annaivanytska/virtualLaboratory/app.png

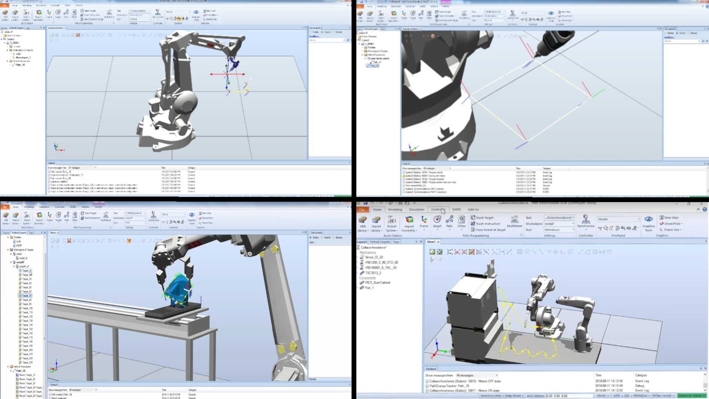
app.png
