annaivanytska/virtualLaboratory/src/model/kkk.png

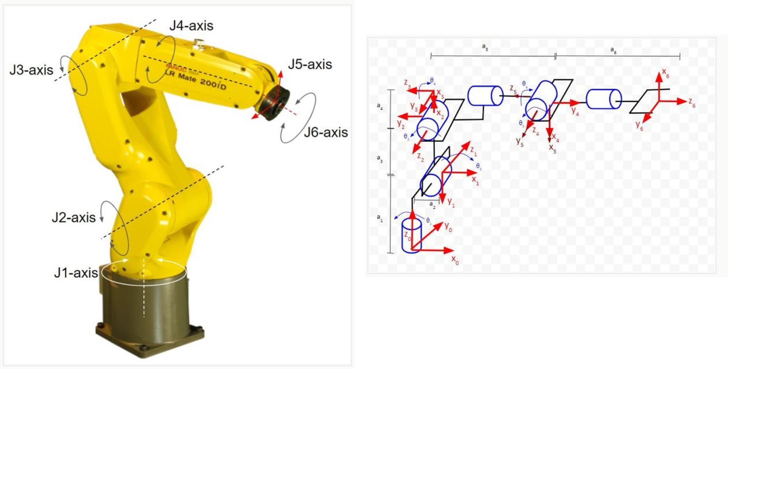
src/model/kkk.png
