annaivanytska/virtualLaboratory/models/Kawasaki/Rysunki 3D/Robot FS006L/człon_3.stl

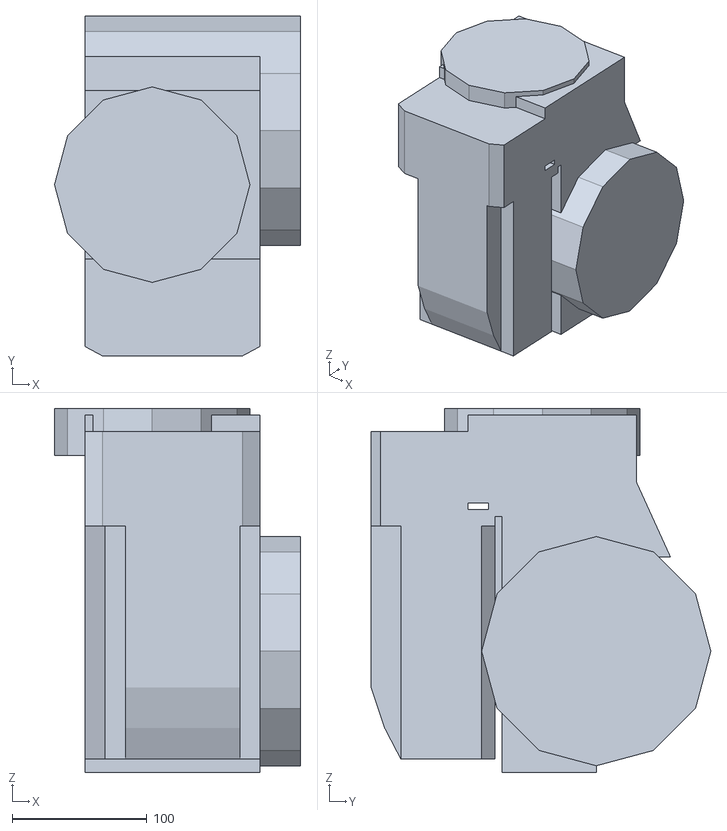
[picture p4: CAD file, 2024-10-11]
models/Kawasaki/Rysunki 3D/Robot FS006L/człon_3.stl
182.5 x 252.0 x 270.0
