annaivanytska/virtualLaboratory/models/Kawasaki/Rysunki 3D/Robot FS060L/fs006l-ip.dxf

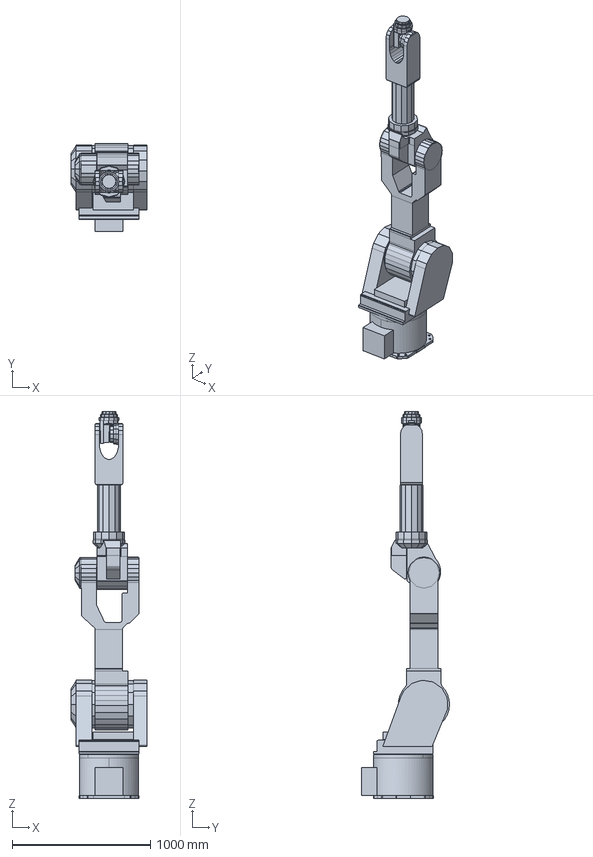
[picture p5: CAD file, 2024-10-11]
models/Kawasaki/Rysunki 3D/Robot FS060L/fs006l-ip.dxf
547.0 x 636.2 x 2796.0 mm
