annaivanytska/virtualLaboratory/models/Kawasaki/Rysunki 3D/Robot RS003N/RS003N.stp

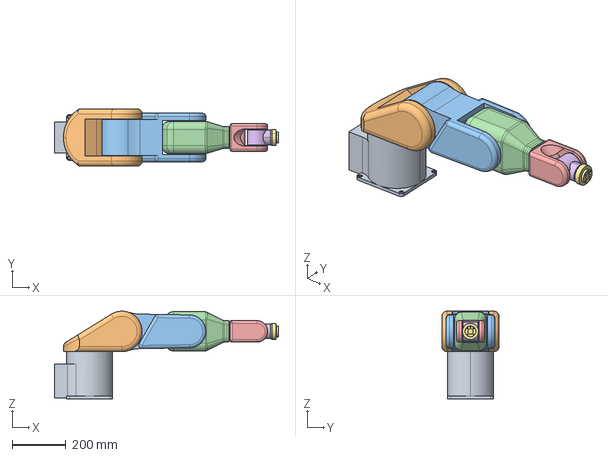
[picture p6: CAD file, 2024-10-11]
models/Kawasaki/Rysunki 3D/Robot RS003N/RS003N.stp
830.0 x 212.0 x 324.9 mm
