annaivanytska/virtualLaboratory/models/Mitsubishi/Rysunki 3D/RV-12/_RV_12SL__RV_12SDL 0/podstawa.stl

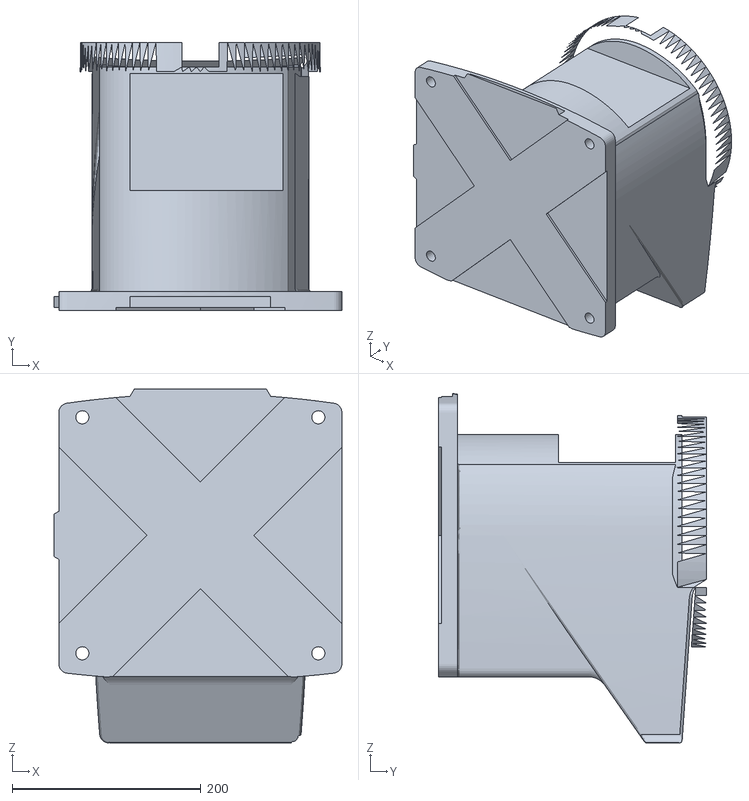
[picture p7: CAD file, 2024-10-11]
models/Mitsubishi/Rysunki 3D/RV-12/_RV_12SL__RV_12SDL 0/podstawa.stl
305.0 x 284.0 x 375.0
