annaivanytska/virtualLaboratory/models/Mitsubishi/Rysunki 3D/RV-12/RV_12SL_Robot_arm_dimensions.dxf

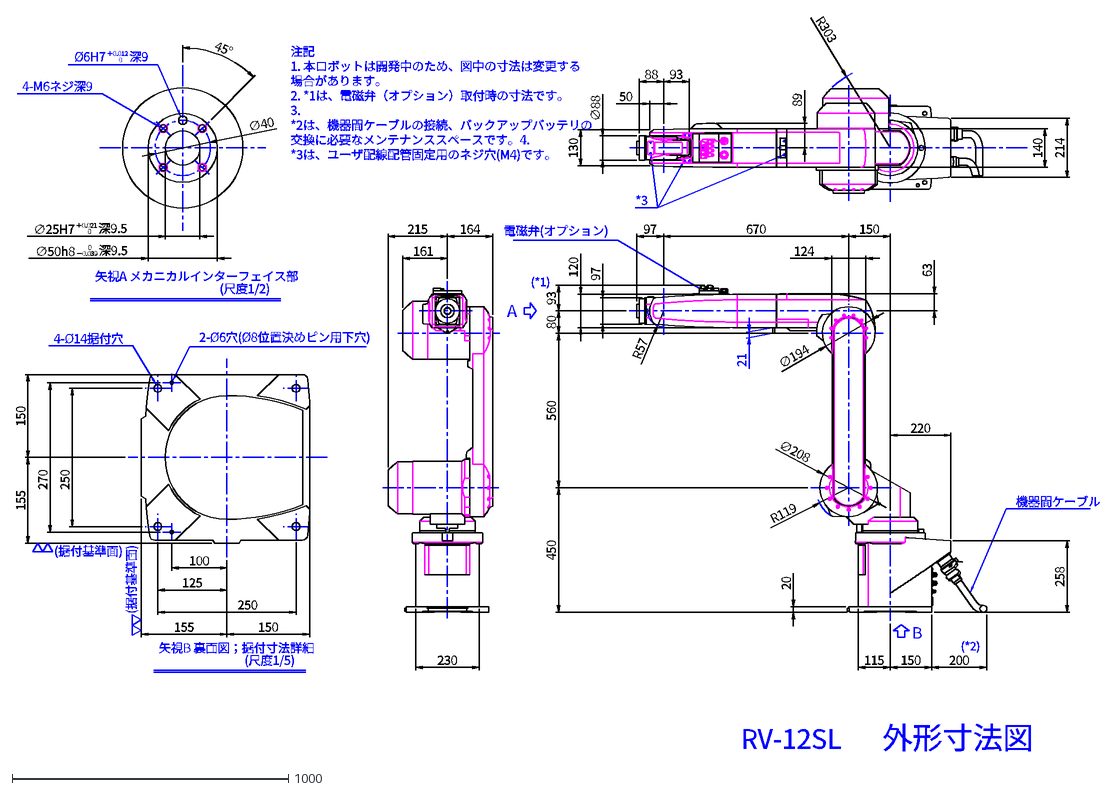
[picture p8: CAD file, 2024-10-11]
models/Mitsubishi/Rysunki 3D/RV-12/RV_12SL_Robot_arm_dimensions.dxf
2-Ø6穴(Ø8位置決めピン用下穴)
155
250
270
150
矢視B 裏面図；据付寸法詳細
125
100
(尺度1/5)
45°
∅25H7 ＋0.021^ 0 深9.5
∅50h8 0^ －0.039 深9.5
4-Ø14据付穴
矢視A メカニカルインターフェイス部
(尺度1/2)
∅40
Ø6H7 ＋0.012^ 0 深9
560
∅208
220
450
R119
230
機器間ケーブル
258
外形寸法図
RV-12SL
115
B
200
(*2)
124
R303
670
∅194
63
電磁弁(オプション)
(*1)
130
93
80
215
164
161
A
97
120
R57
88
50
∅88
89
注記 1. 本ロボットは開発中のため、図中の寸法は変更する 場合があります。 2. *1は、電磁弁（オプション）取付時の寸法です。 3. *2は、機器間ケーブルの接続、バックアップバッテリの 交換に必要なメンテナンススペースです。 4. *3は、ユーザ配線配管固定用のネジ穴(M4)です。
140
214
(据付基準面)
20
*3
4-M6ネジ深9
21
