annaivanytska/virtualLaboratory/models/Modele 3D/Kawasaki/fs006l.stp

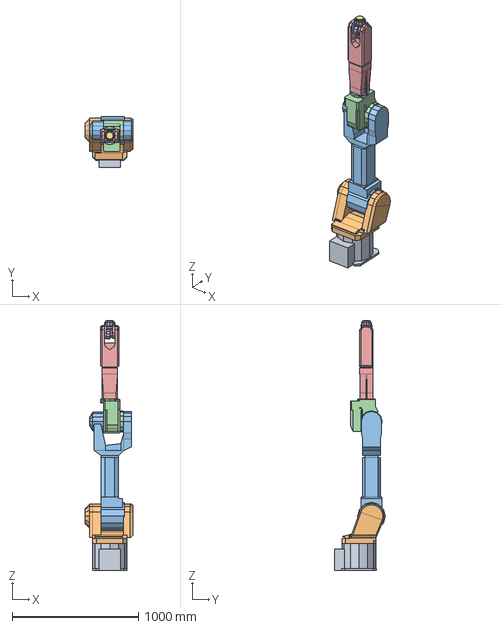
[picture p9: CAD file, 2024-10-11]
models/Modele 3D/Kawasaki/fs006l.stp
378.0 x 402.0 x 1980.0 mm
