annaivanytska/virtualLaboratory/models/Modele 3D/Mitsubishi/RV-12/_RV_12SL__RV_12SDL 0/rv-12sl_top.stp

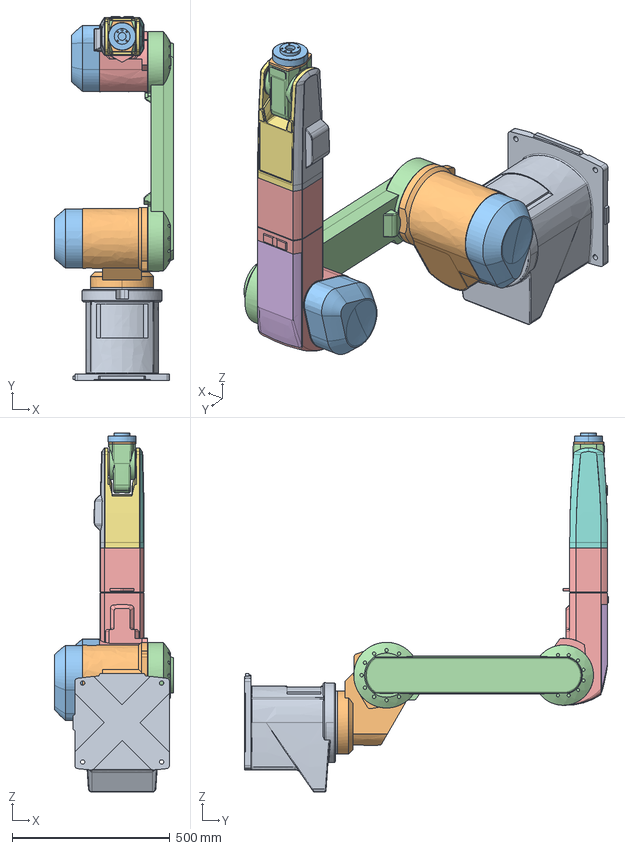
[picture p10: CAD file, 2024-10-11]
models/Modele 3D/Mitsubishi/RV-12/_RV_12SL__RV_12SDL 0/rv-12sl_top.stp
378.5 x 1153.0 x 1137.0 mm
RV-12SL_SKELTON
RV-12S_BASE
RV-12S_SHOULDER
RV-12S_SHOULDER_COVER x 2
RV-12SL_NO1ARM
RV-12S_ELBO
RV-12S_ELBO_COVER_A
RV-12S_NO2ARM
RV-12S_NO2ARM_COVER_A
RV-12S_NO2ARM_COVER_B
RV-12S_J6_CRBRG_SPACER
RV-12S_J6_FLANGE
RV-12S_WRIST
RV-12SL_J4_EX_FLANGE
