annaivanytska/virtualLaboratory/models/Modele 3D/Mitsubishi/RV-12/_RV_12SL__RV_12SDL 1/rv-12sl_no1arm.igs

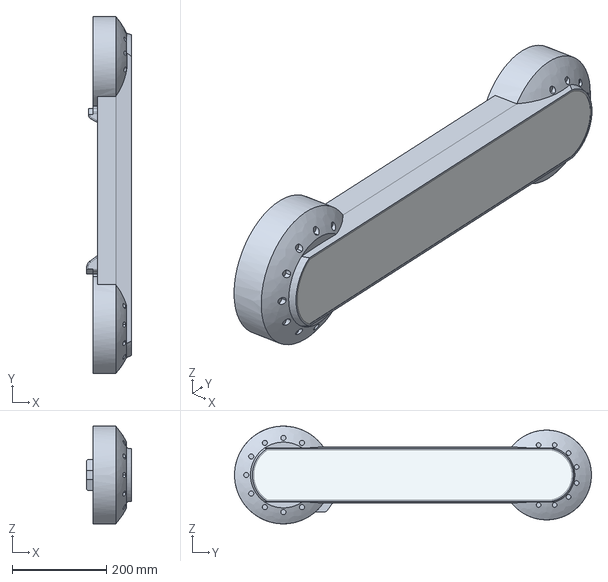
[picture p11: CAD file, 2024-10-11]
models/Modele 3D/Mitsubishi/RV-12/_RV_12SL__RV_12SDL 1/rv-12sl_no1arm.igs
95.0 x 759.5 x 207.9 mm
