annaivanytska/virtualLaboratory/models/Modele 3D/Modele STL/mitsubishi/rv-12s_j6_crbrg_spacer.stl

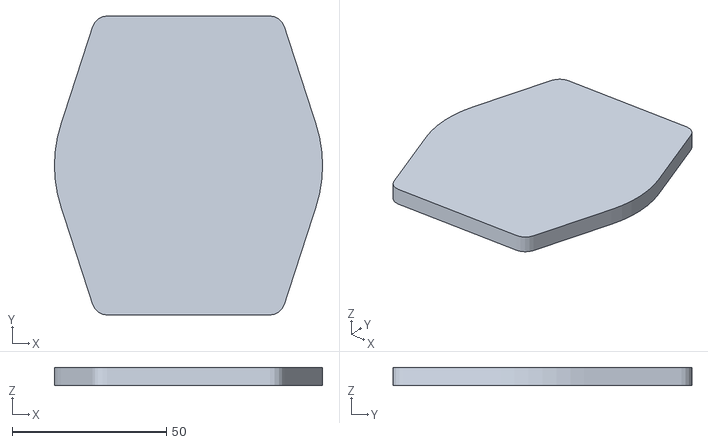
[picture p12: CAD file, 2024-10-11]
models/Modele 3D/Modele STL/mitsubishi/rv-12s_j6_crbrg_spacer.stl
87.0 x 97.0 x 6.00
