annaivanytska/virtualLaboratory/src/kawasaki/23.stl

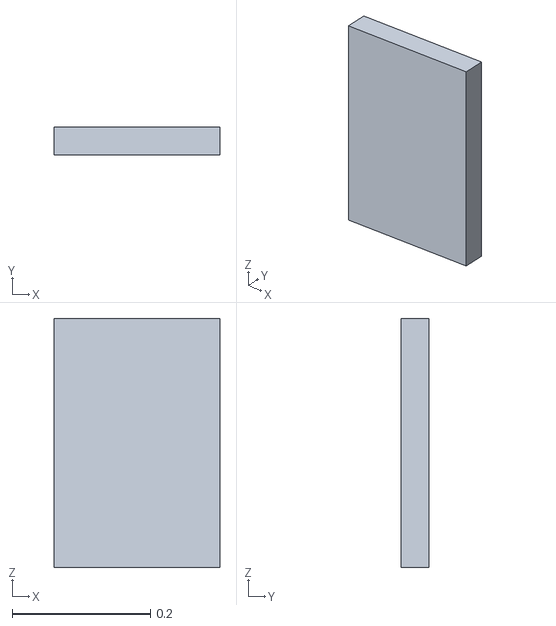
[picture p13: CAD file, 2025-04-29]
src/kawasaki/23.stl
0.24 x 0.04 x 0.36
