annaivanytska/virtualLaboratory/models/Kawasaki/Rysunki 3D/Robot FS006L/człon_2.stl

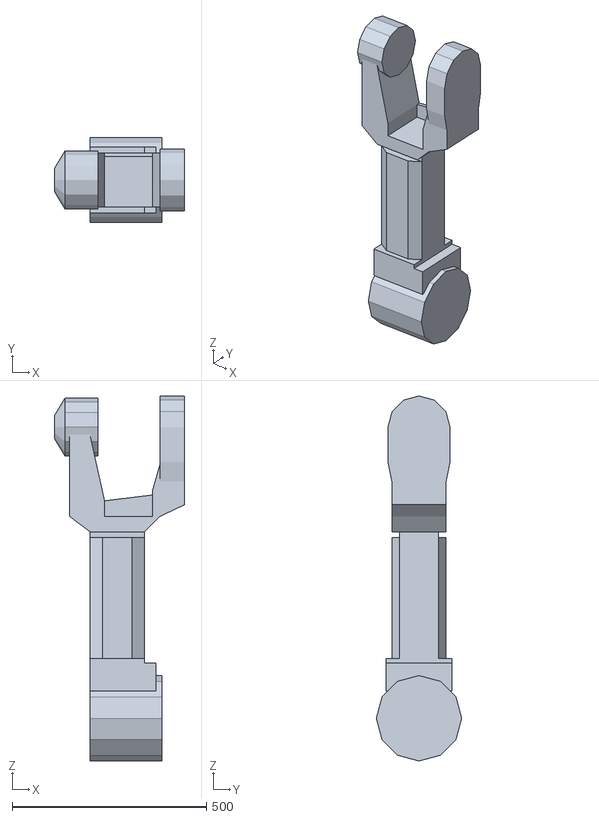
[picture p15: CAD file, 2024-10-11]
models/Kawasaki/Rysunki 3D/Robot FS006L/człon_2.stl
335.0 x 220.0 x 940.0
