annaivanytska/virtualLaboratory/models/Mitsubishi/Rysunki 3D/RV-12/RV_12SL_Robot_arm_reach__dimensioned_.dxf

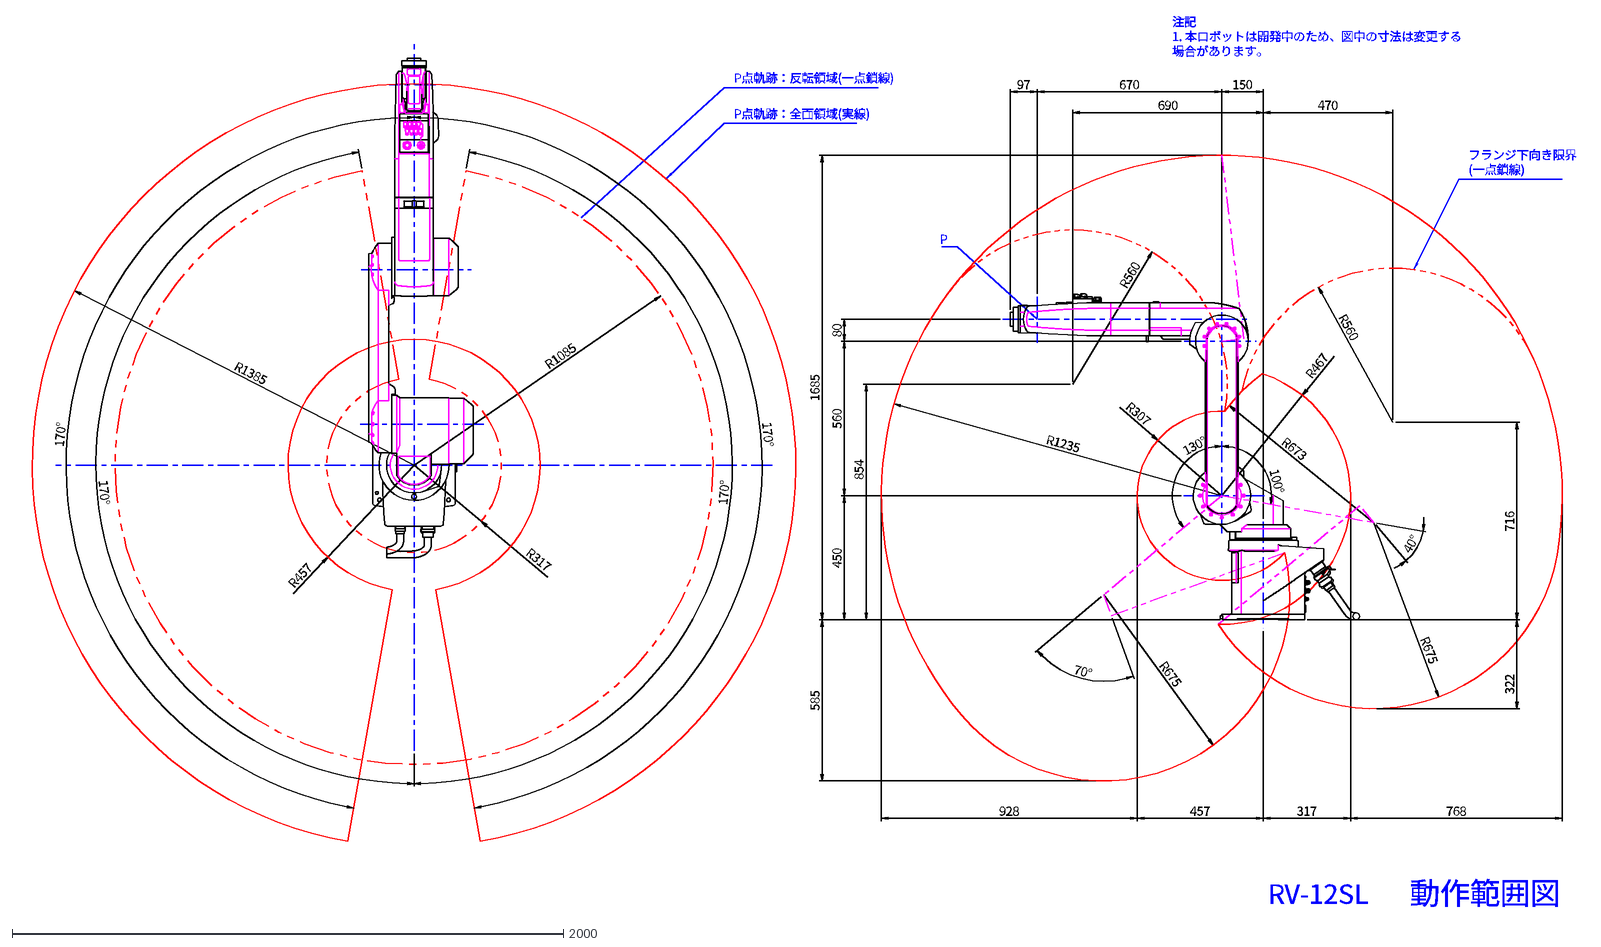
[picture p16: CAD file, 2024-10-11]
models/Mitsubishi/Rysunki 3D/RV-12/RV_12SL_Robot_arm_reach__dimensioned_.dxf
動作範囲図
RV-12SL
560
450
80
150
670
97
457
928
317
768
585
1685
690
854
716
470
R307
R560
R1235
R467
R673
R675
130°
100°
170°
R1385
R1085
R457
R317
P
フランジ下向き限界 (一点鎖線)
P点軌跡：全面領域(実線)
P点軌跡：反転領域(一点鎖線)
注記 1. 本ロボットは開発中のため、図中の寸法は変更する 場合があります。
70°
40°
322
