annaivanytska/virtualLaboratory/models/Modele 3D/Kawasaki/podstawa.stl

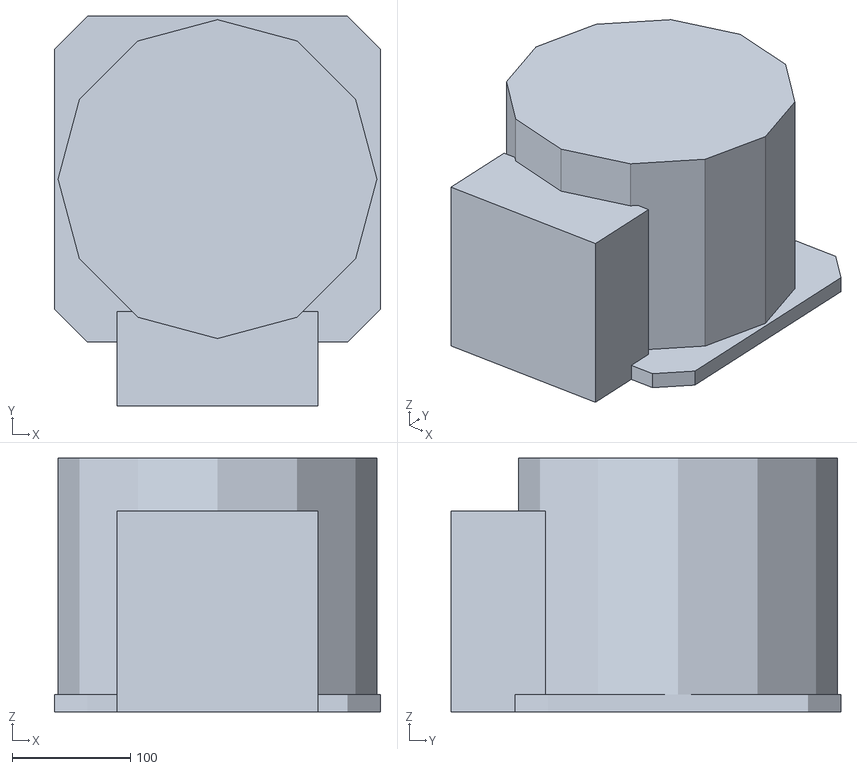
[picture p17: CAD file, 2024-10-11]
models/Modele 3D/Kawasaki/podstawa.stl
276.0 x 330.0 x 215.0
