annaivanytska/virtualLaboratory/models/Modele 3D/Mitsubishi/RV-12/_RV_12SL__RV_12SDL 1/rv-12s_elbo.igs

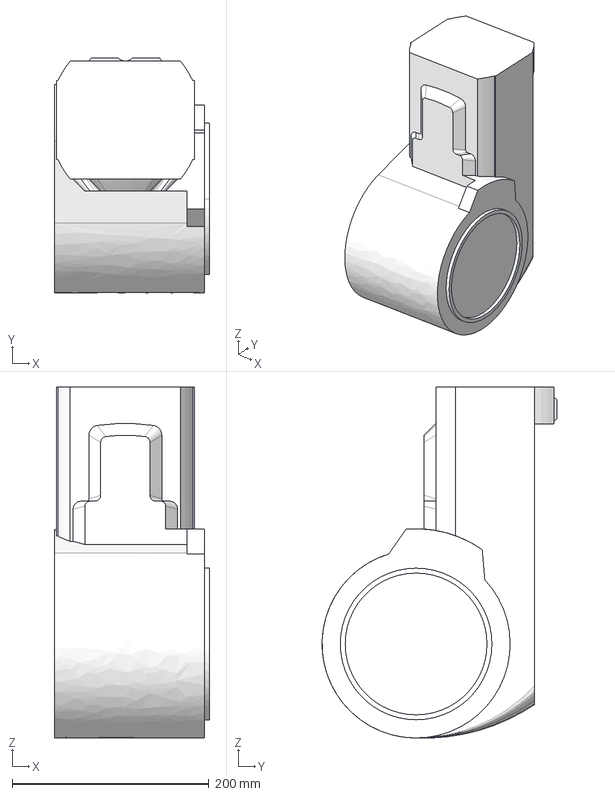
[picture p18: CAD file, 2024-10-11]
models/Modele 3D/Mitsubishi/RV-12/_RV_12SL__RV_12SDL 1/rv-12s_elbo.igs
157.5 x 238.5 x 356.5 mm
