annaivanytska/virtualLaboratory/models/Modele 3D/Modele STL/kawasaki/czlon_1.ply

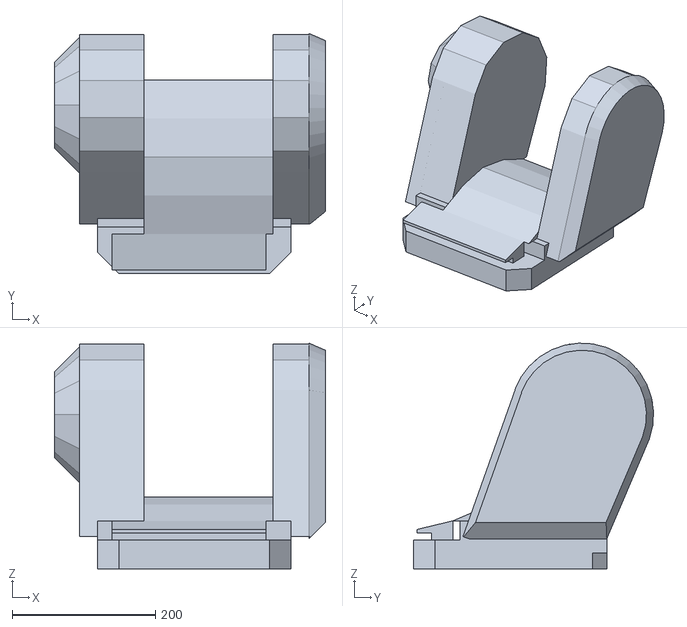
[picture p19: CAD file, 2024-10-11]
models/Modele 3D/Modele STL/kawasaki/czlon_1.ply
378.0 x 334.9 x 314.9
