annaivanytska/virtualLaboratory/src/model/1-5.stl

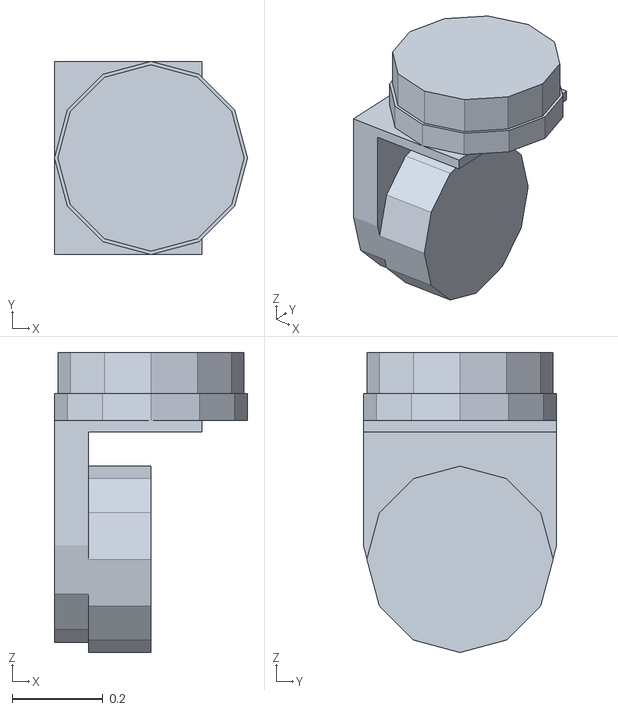
[picture p20: CAD file, 2025-04-29]
src/model/1-5.stl
0.425 x 0.425 x 0.66
