annaivanytska/virtualLaboratory/models/Kawasaki/Rysunki 3D/Robot FS006L/człon_4.stl

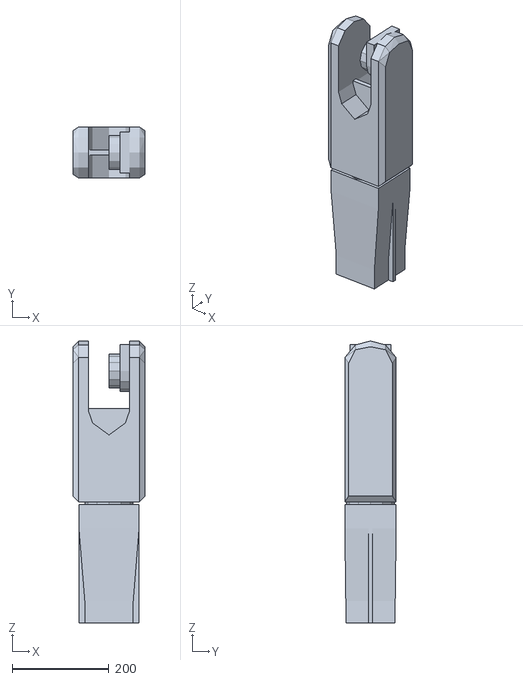
[picture p21: CAD file, 2024-10-11]
models/Kawasaki/Rysunki 3D/Robot FS006L/człon_4.stl
149.0 x 106.0 x 582.0
