annaivanytska/virtualLaboratory/models/Modele 3D/Kawasaki/człon_6_flansza.stl

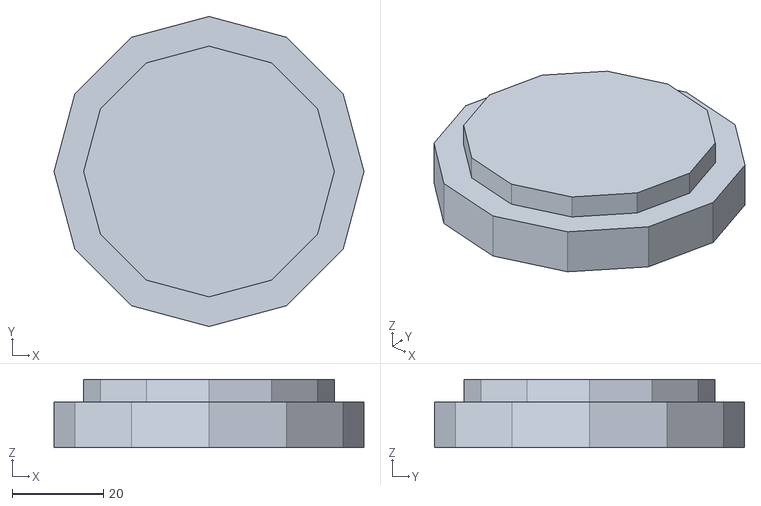
[picture p22: CAD file, 2024-10-11]
models/Modele 3D/Kawasaki/człon_6_flansza.stl
68.0 x 68.0 x 15.0
