annaivanytska/virtualLaboratory/models/Modele 3D/Mitsubishi/RV-12/_RV_12SL__RV_12SDL 1/człon_0_podstawa.stl

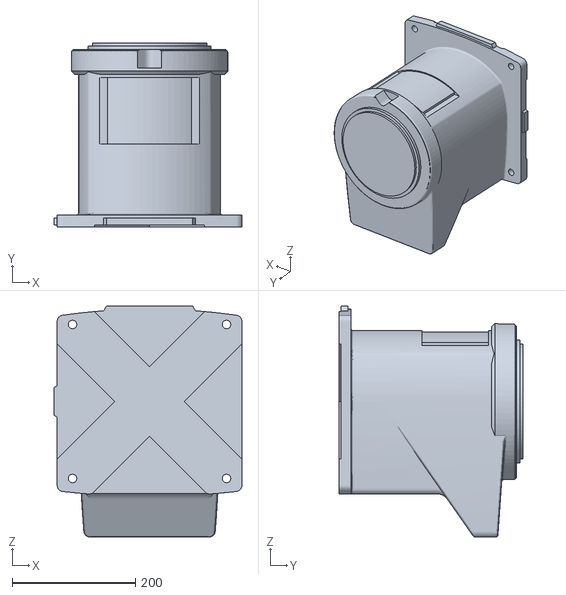
[picture p23: CAD file, 2024-10-11]
models/Modele 3D/Mitsubishi/RV-12/_RV_12SL__RV_12SDL 1/człon_0_podstawa.stl
305.0 x 299.0 x 375.0
