annaivanytska/virtualLaboratory/src/model/000.obj

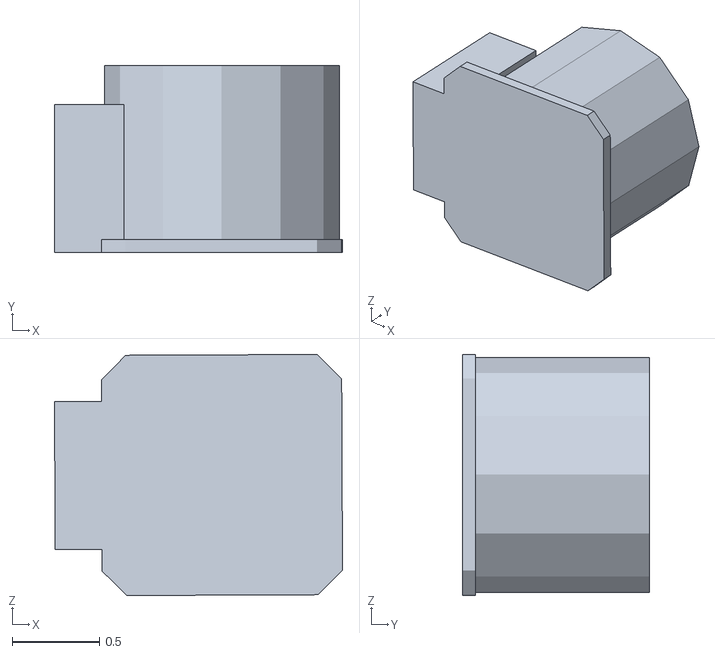
[picture p24: CAD file, 2025-04-29]
src/model/000.obj
1.65 x 1.07 x 1.38
