annaivanytska/virtualLaboratory/models/Kawasaki/Rysunki 3D/Robot FS006L/fs006l-ip.dxf

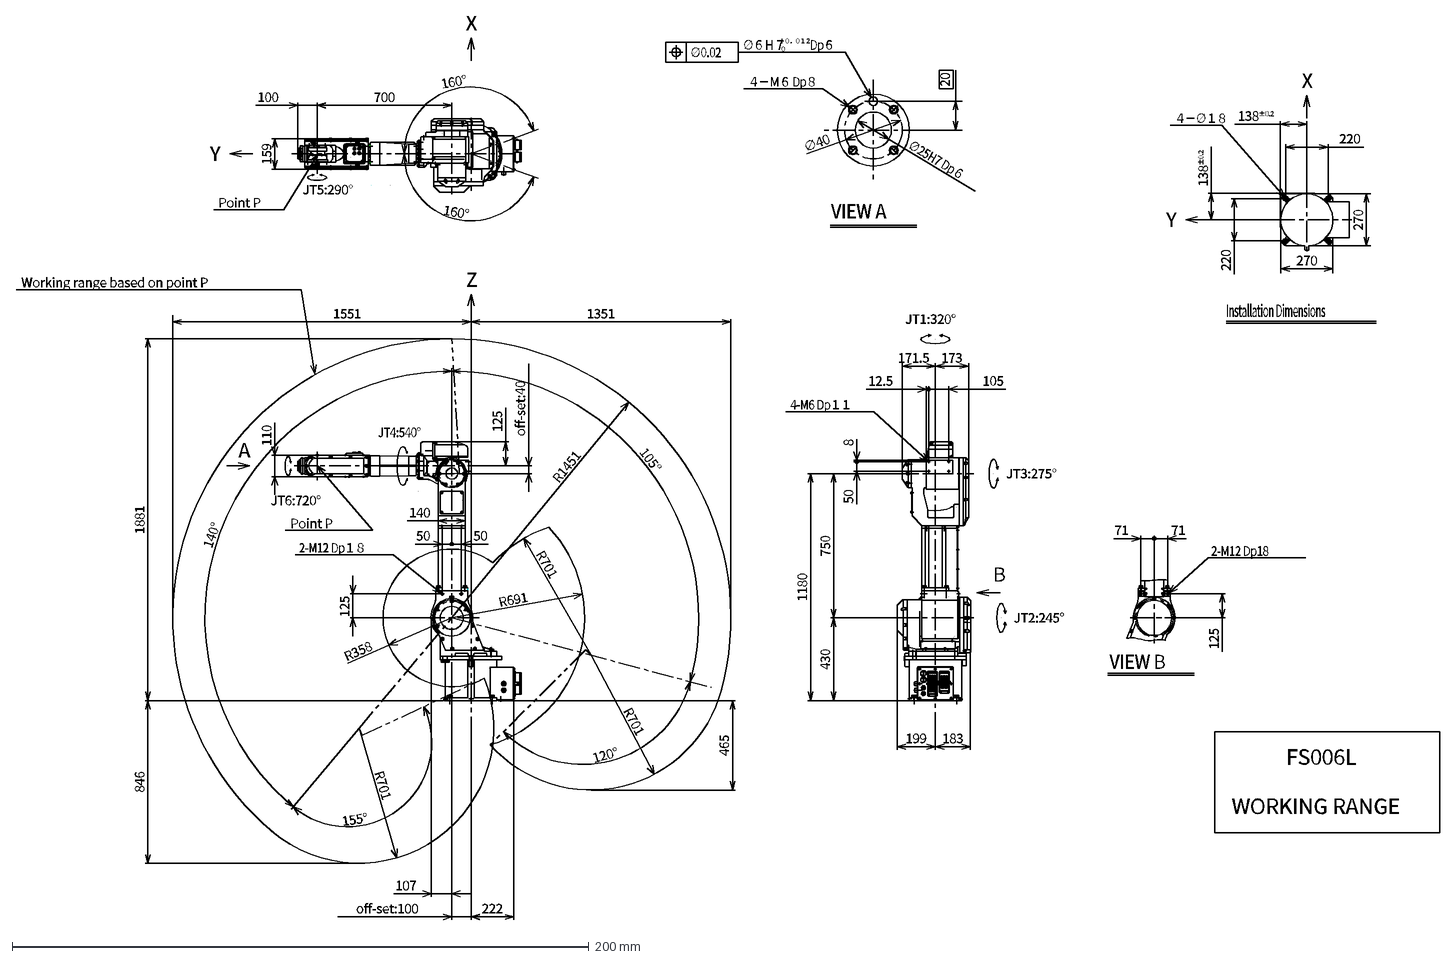
[picture p25: CAD file, 2024-10-11]
models/Kawasaki/Rysunki 3D/Robot FS006L/fs006l-ip.dxf
JT5:290°
Y
X
B
JT1:320°
JT2:245°
JT6:720°
A
Z
VIEW B
JT3:275°
JT4:540°
Installation Dimensions
105°
846
1881
100
160°
222
125
50
2-M12 Dp18
71
8
4-M6 Dp１１
12.5
171.5
173
R701
183
430
140°
140
107
R1451
off-set:40
off-set:100
R691
1351
465
1551
R358
270
220
138±0.2^
４－∅１８
700
750
1180
155°
120°
199
Point P
Working range based on point P
2-M12 Dp１８
105
159
110
WORKING RANGE
FS006L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
