annaivanytska/virtualLaboratory/models/Mitsubishi/Rysunki 3D/RV-12/_RV_12SL__RV_12SDL 1/rv-12s_no2arm.igs

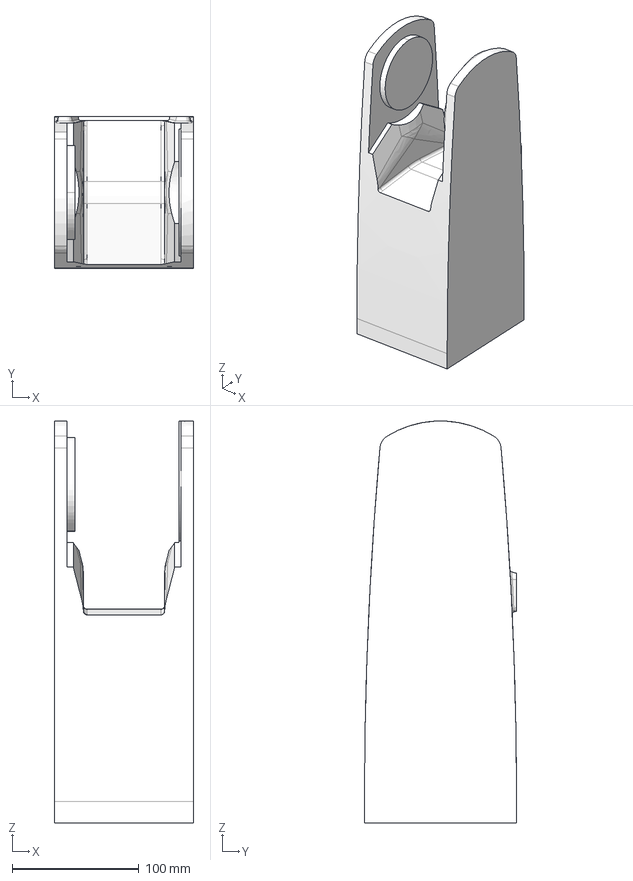
[picture p26: CAD file, 2024-10-11]
models/Mitsubishi/Rysunki 3D/RV-12/_RV_12SL__RV_12SDL 1/rv-12s_no2arm.igs
110.0 x 120.0 x 317.0 mm
