annaivanytska/virtualLaboratory/src/kawasaki/4a.stl

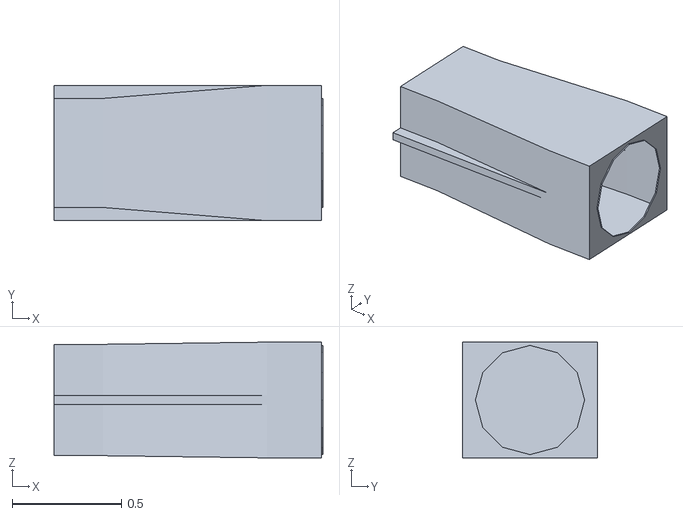
[picture p27: CAD file, 2025-04-29]
src/kawasaki/4a.stl
1.23 x 0.62 x 0.53
