annaivanytska/virtualLaboratory/src/model/1-4a.stl

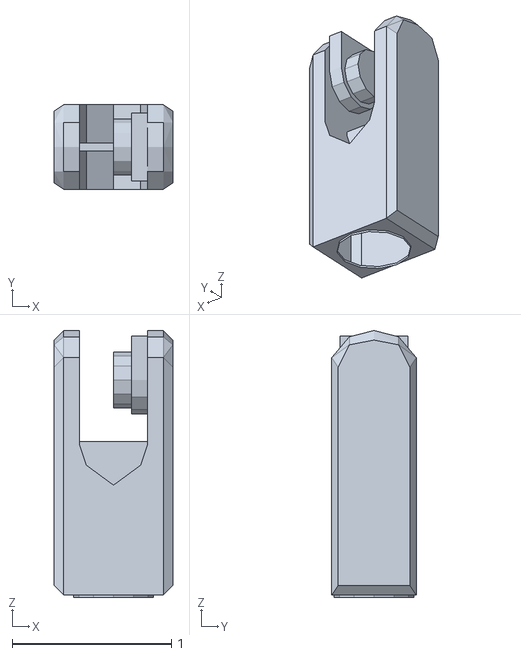
[picture p28: CAD file, 2025-04-29]
src/model/1-4a.stl
0.745 x 0.53 x 1.67
