annaivanytska/virtualLaboratory/models/Modele 3D/Kawasaki/człon_5.stl

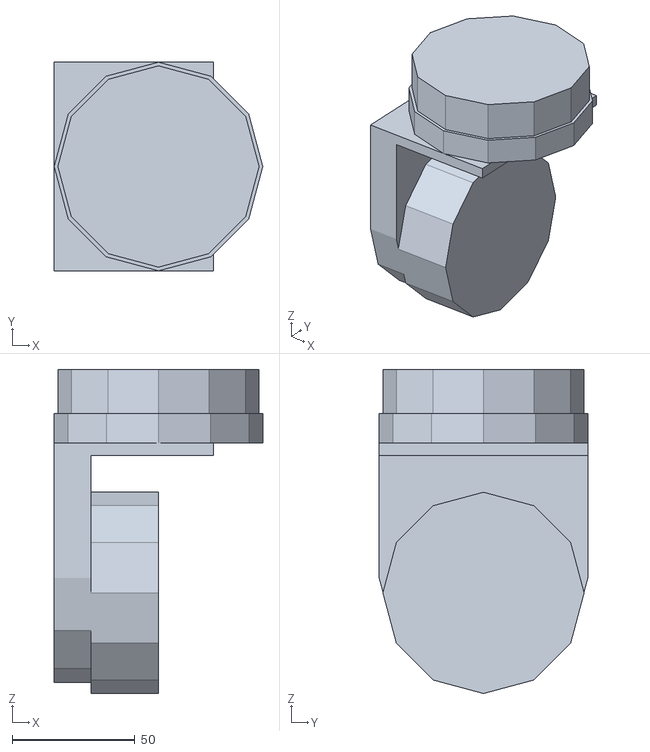
[picture p29: CAD file, 2024-10-11]
models/Modele 3D/Kawasaki/człon_5.stl
85.0 x 85.0 x 132.0
