annaivanytska/virtualLaboratory/models/Modele 3D/Modele STL/mitsubishi/rv-12s_no2arm_cover_a.stl

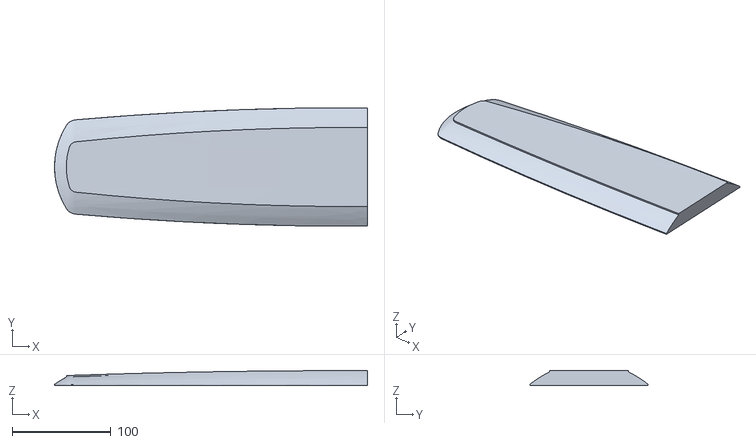
[picture p30: CAD file, 2024-10-11]
models/Modele 3D/Modele STL/mitsubishi/rv-12s_no2arm_cover_a.stl
317.0 x 120.0 x 15.0
