annaivanytska/virtualLaboratory/src/kawasaki/1.stl

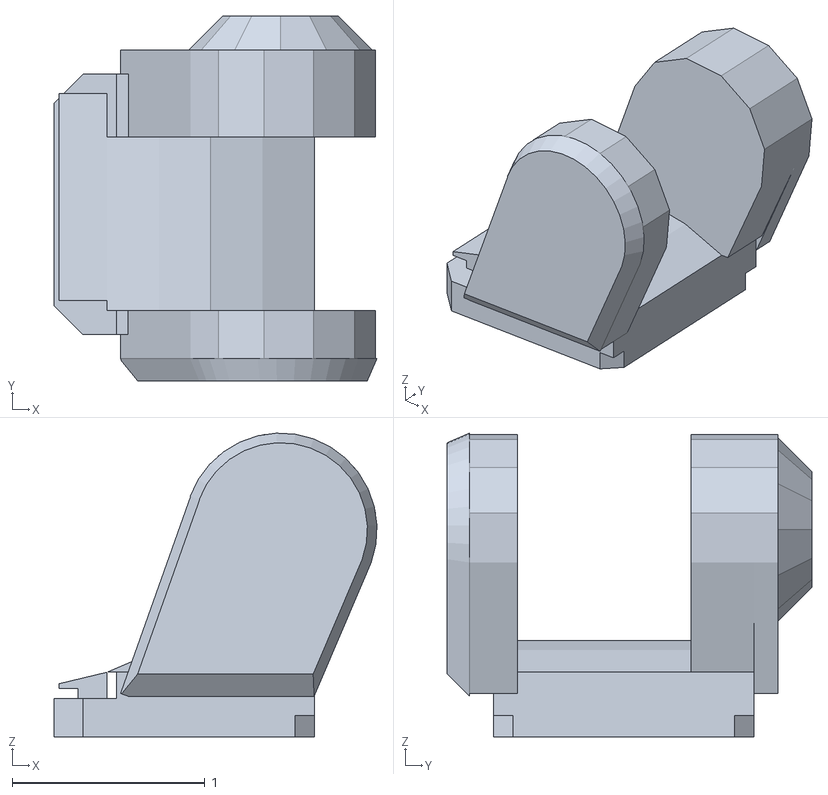
[picture p31: CAD file, 2025-04-29]
src/kawasaki/1.stl
1.67 x 1.89 x 1.57
