annaivanytska/virtualLaboratory/models/Modele 3D/Modele STL/mitsubishi/rv-12sl_j4_ex_flange.stl

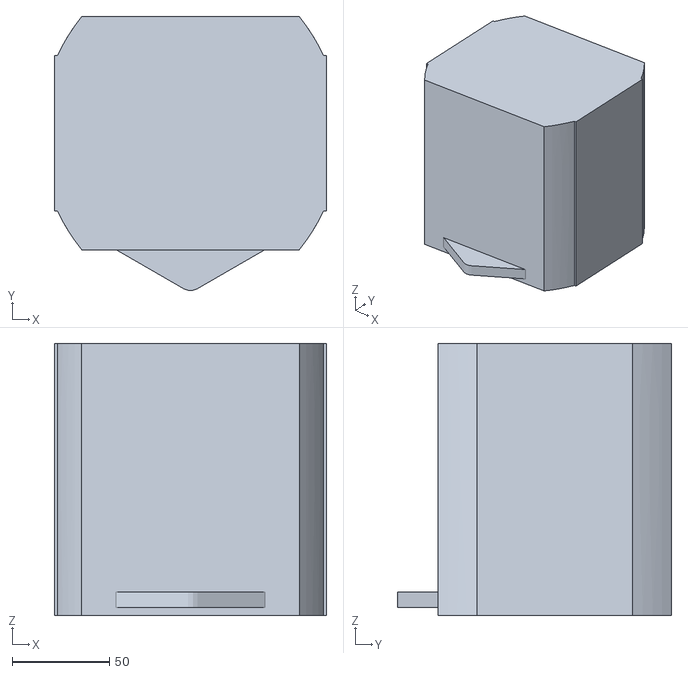
[picture p32: CAD file, 2024-10-11]
models/Modele 3D/Modele STL/mitsubishi/rv-12sl_j4_ex_flange.stl
140.0 x 140.9 x 140.0
