annaivanytska/virtualLaboratory/models/Modele 3D/Mitsubishi/RV-12/_RV_12SL__RV_12SDL 1/rv-12s_wrist.igs

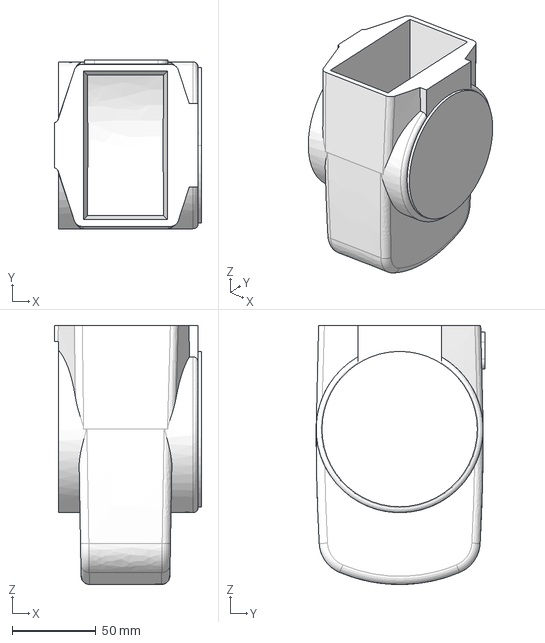
[picture p34: CAD file, 2024-10-11]
models/Modele 3D/Mitsubishi/RV-12/_RV_12SL__RV_12SDL 1/rv-12s_wrist.igs
88.0 x 101.0 x 155.0 mm
