annaivanytska/virtualLaboratory/models/Modele 3D/Modele STL/mitsubishi/rv-12s_shoulder.stl

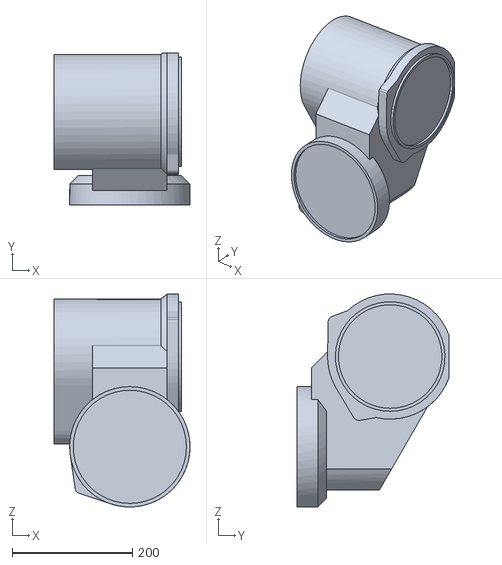
[picture p35: CAD file, 2024-10-11]
models/Modele 3D/Modele STL/mitsubishi/rv-12s_shoulder.stl
225.9 x 253.0 x 353.9
