annaivanytska/virtualLaboratory/models/Modele 3D/Modele STL/mitsubishi/rv-12s_wrist.stl

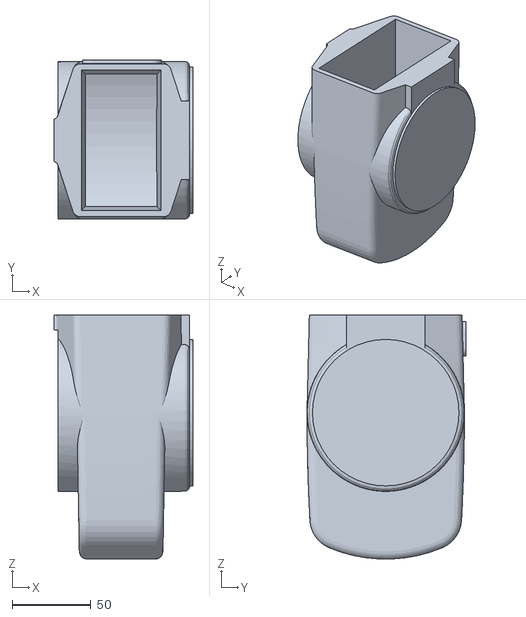
[picture p36: CAD file, 2024-10-11]
models/Modele 3D/Modele STL/mitsubishi/rv-12s_wrist.stl
88.0 x 101.0 x 154.9
