annaivanytska/virtualLaboratory/src/model/00.stl

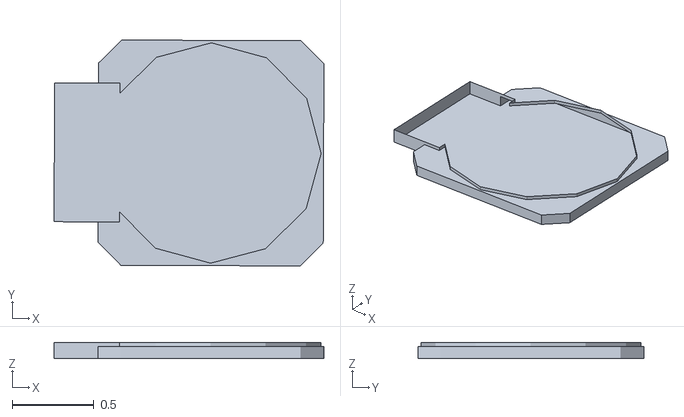
[picture p37: CAD file, 2025-04-29]
src/model/00.stl
1.65 x 1.38 x 0.0983
