annaivanytska/virtualLaboratory/models/Mitsubishi/Rysunki 3D/RV-12/_RV_12SL__RV_12SDL 1/rv-12s_j6_flange.igs

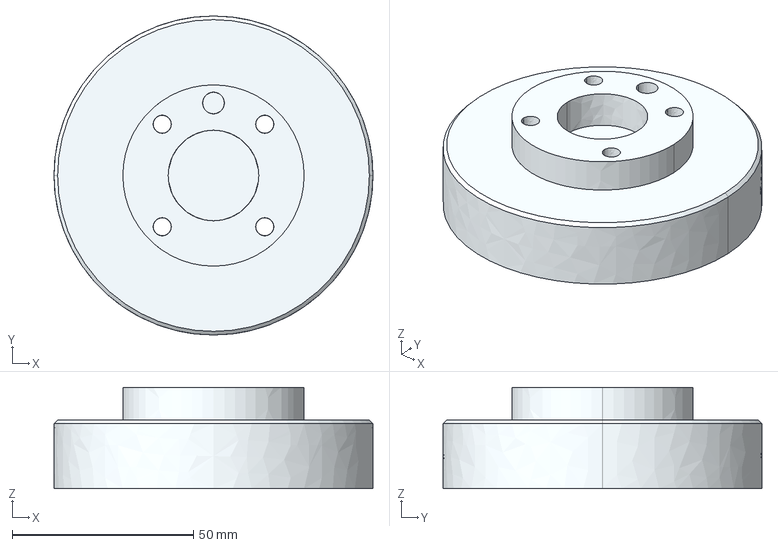
[picture p38: CAD file, 2024-10-11]
models/Mitsubishi/Rysunki 3D/RV-12/_RV_12SL__RV_12SDL 1/rv-12s_j6_flange.igs
88.0 x 88.0 x 28.0 mm
