annaivanytska/virtualLaboratory/models/Modele 3D/Mitsubishi/RV-12/_RV_12SL__RV_12SDL 1/rv-12s_elbo_cover_a.igs

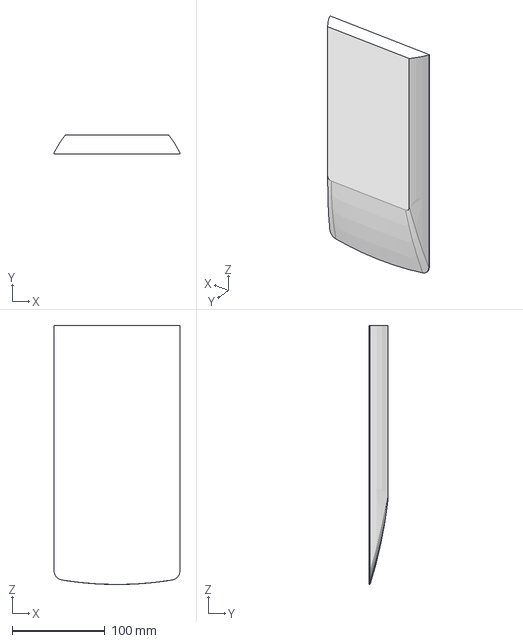
[picture p39: CAD file, 2024-10-11]
models/Modele 3D/Mitsubishi/RV-12/_RV_12SL__RV_12SDL 1/rv-12s_elbo_cover_a.igs
136.0 x 20.0 x 280.0 mm
