annaivanytska/virtualLaboratory/src/kawasaki/2.stl

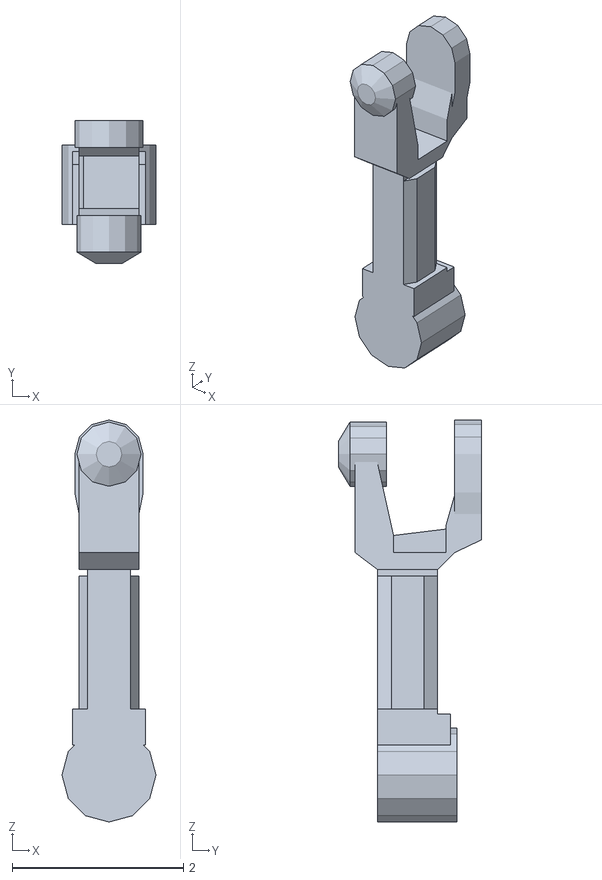
[picture p40: CAD file, 2025-04-29]
src/kawasaki/2.stl
1.10 x 1.67 x 4.70
