annaivanytska/virtualLaboratory/models/Modele 3D/Modele STL/mitsubishi/ConvexHull.stl

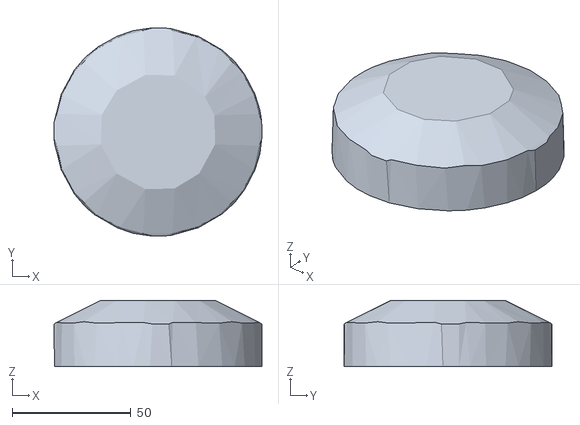
[picture p41: CAD file, 2024-10-11]
models/Modele 3D/Modele STL/mitsubishi/ConvexHull.stl
87.8 x 87.8 x 28.0
