annaivanytska/virtualLaboratory/src/kawasaki/3.stl

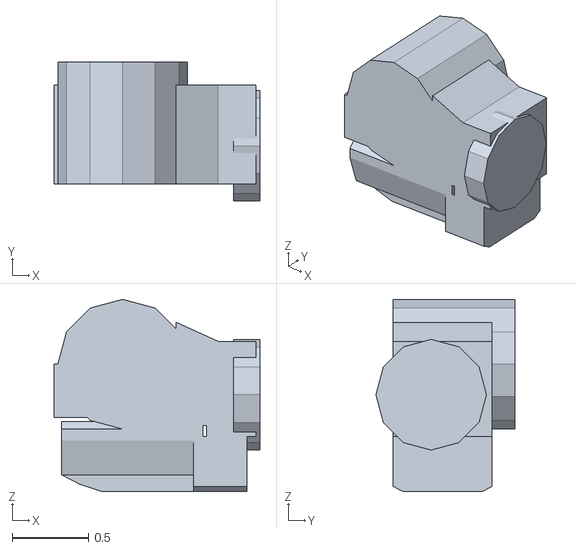
[picture p42: CAD file, 2025-04-29]
src/kawasaki/3.stl
1.35 x 0.913 x 1.26
