annaivanytska/virtualLaboratory/models/Mitsubishi/Rysunki 3D/RV-12/_RV_12SL__RV_12SDL 1/rv-12s_shoulder_cover.igs

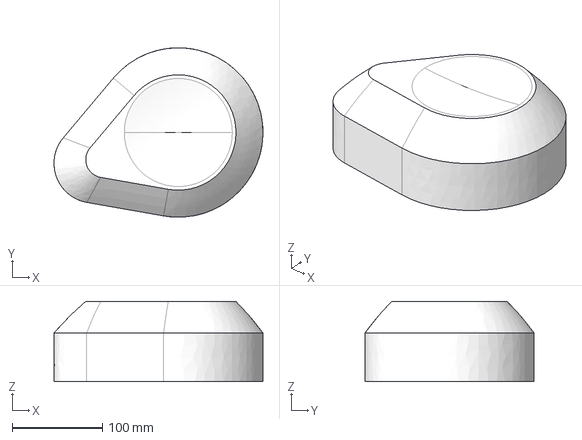
[picture p43: CAD file, 2024-10-11]
models/Mitsubishi/Rysunki 3D/RV-12/_RV_12SL__RV_12SDL 1/rv-12s_shoulder_cover.igs
231.9 x 188.0 x 89.0 mm
