annaivanytska/virtualLaboratory/src/kawasaki/6.stl

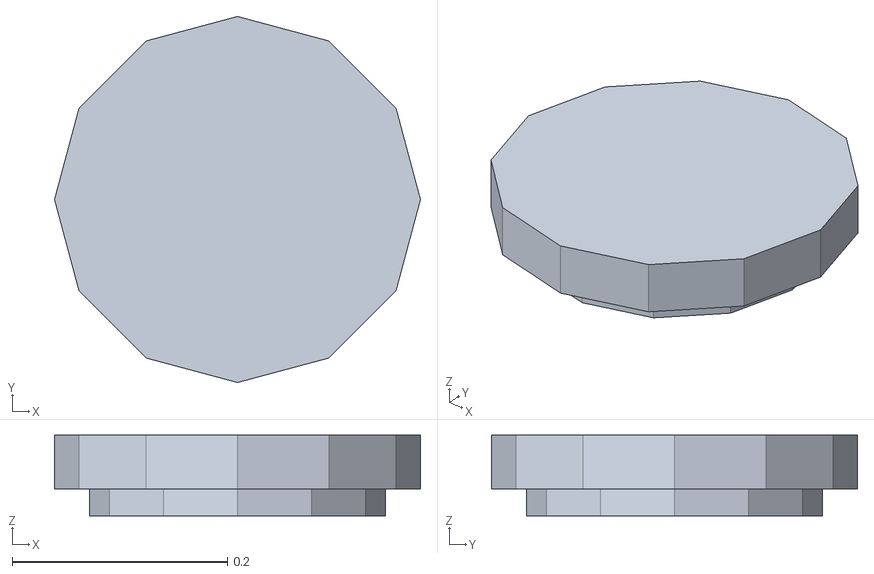
[picture p44: CAD file, 2025-04-29]
src/kawasaki/6.stl
0.34 x 0.34 x 0.075
