annaivanytska/virtualLaboratory/src/model/2-0.stl

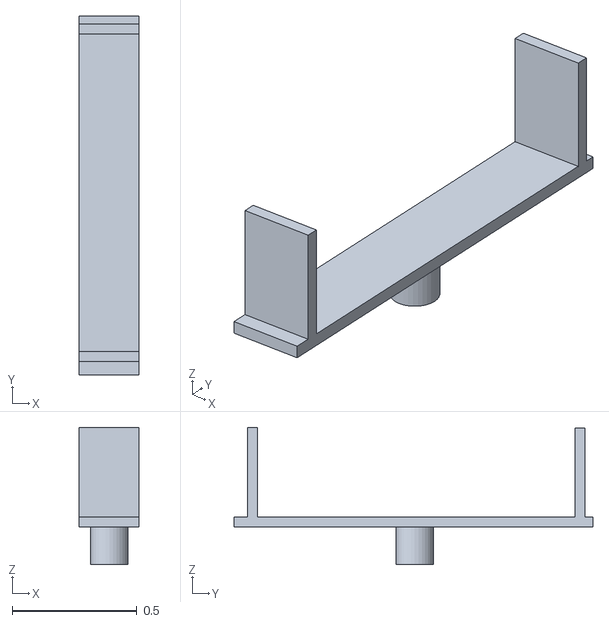
[picture p45: CAD file, 2025-04-29]
src/model/2-0.stl
0.24 x 1.44 x 0.55
