annaivanytska/virtualLaboratory/src/model/1-4.stl

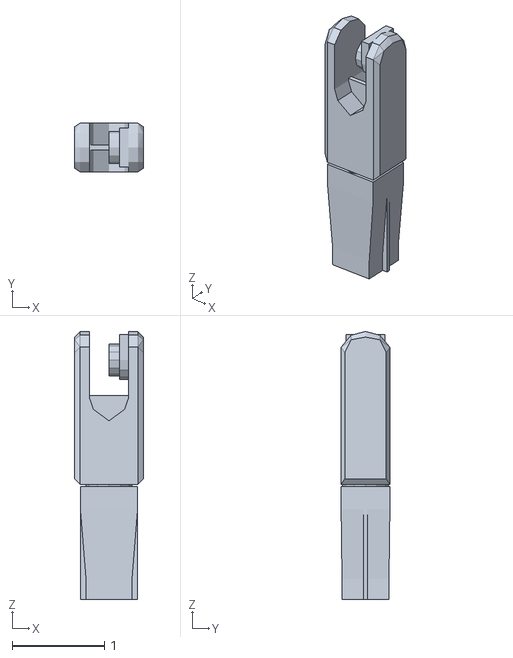
[picture p46: CAD file, 2025-04-29]
src/model/1-4.stl
0.745 x 0.53 x 2.91
