annaivanytska/virtualLaboratory/src/model/1-3.stl

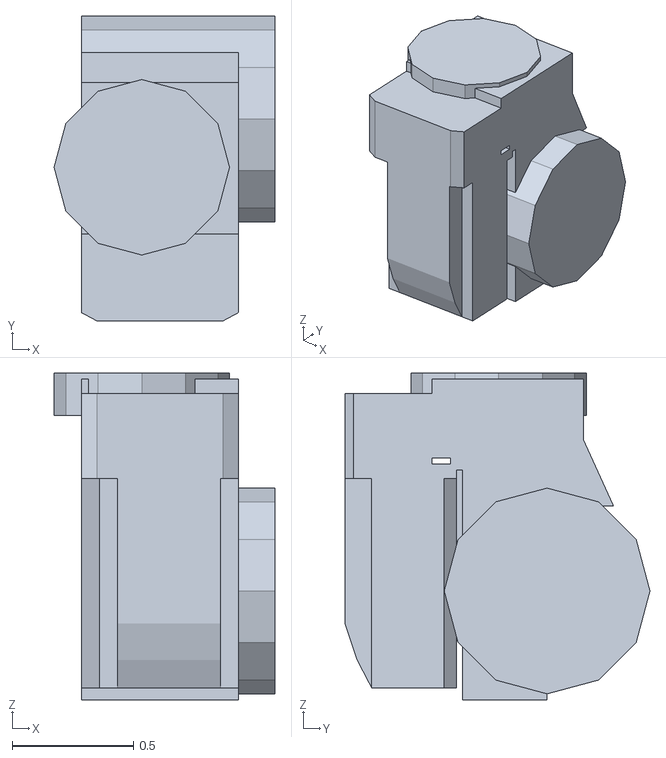
[picture p47: CAD file, 2025-04-29]
src/model/1-3.stl
0.912 x 1.26 x 1.35
