annaivanytska/virtualLaboratory/src/model/cube.stl

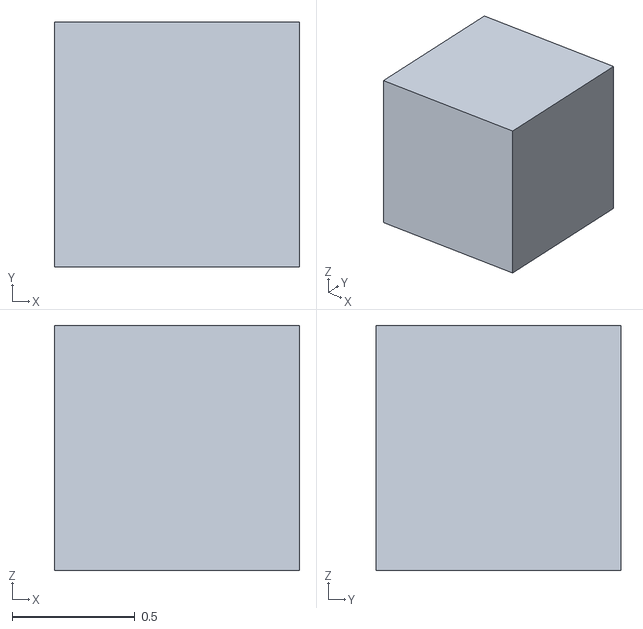
[picture p48: CAD file, 2025-04-29]
src/model/cube.stl
1.00 x 1.00 x 1.00
