annaivanytska/virtualLaboratory/src/model/01.stl

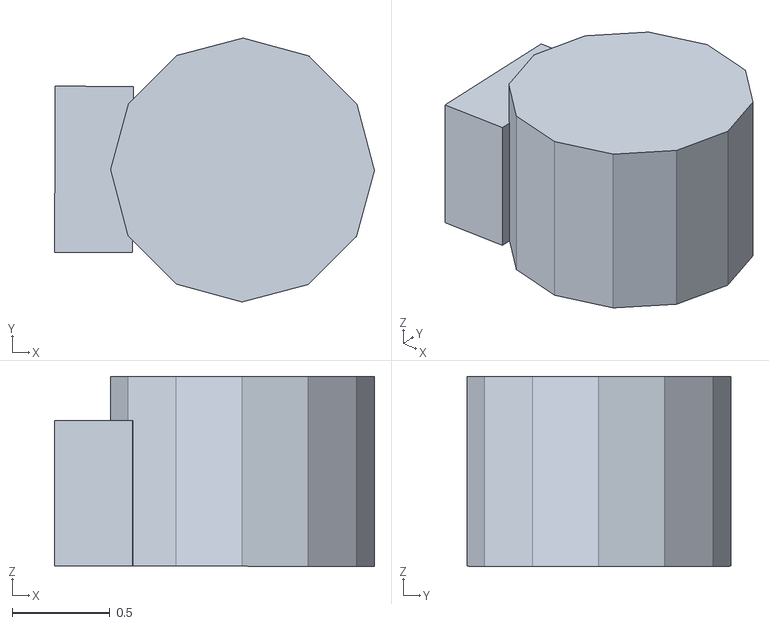
[picture p49: CAD file, 2025-04-29]
src/model/01.stl
1.64 x 1.35 x 0.972
