annaivanytska/virtualLaboratory/models/Modele 3D/Modele STL/tasma/sufit.stl

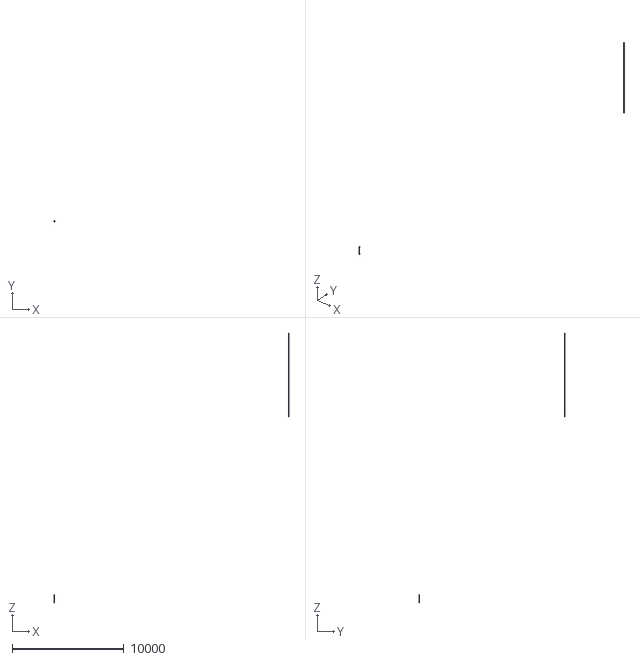
[picture p50: CAD file, 2024-10-11]
models/Modele 3D/Modele STL/tasma/sufit.stl
21064.1 x 13108.8 x 24216.5
