annaivanytska/virtualLaboratory/(list of files, cad)

Other CAD files:
models/Mitsubishi/Rysunki 3D/RV-12/_RV_12SL__RV_12SDL 1/rv-12s_no2arm_assy_asm.igs
models/Mitsubishi/Rysunki 3D/RV-12/_RV_12SL__RV_12SDL 1/rv-12s_shoulder_assy_asm.igs
models/Mitsubishi/Rysunki 3D/RV-12/_RV_12SL__RV_12SDL 1/rv-12s_elbo_assy_asm.igs
models/Modele 3D/Mitsubishi/RV-12/_RV_12SL__RV_12SDL 1/rv-12s_j6_drive_unit_asm.igs
models/Mitsubishi/Rysunki 3D/RV-12/_RV_12SL__RV_12SDL 1/rv-12s_wrist_assy_asm.igs
models/Modele 3D/Mitsubishi/RV-12/_RV_12SL__RV_12SDL 1/rv-12s_elbo_assy_asm.igs
models/Mitsubishi/Rysunki 3D/RV-12/_RV_12SL__RV_12SDL 1/rv-12s_j6_drive_unit_asm.igs
models/Mitsubishi/Rysunki 3D/RV-12/_RV_12SL__RV_12SDL 1/rv-12sl_asm.igs
models/Modele 3D/Mitsubishi/RV-12/_RV_12SL__RV_12SDL 1/rv-12s_wrist_assy_asm.igs
models/Modele 3D/Mitsubishi/RV-12/_RV_12SL__RV_12SDL 1/rv-12s_shoulder_assy_asm.igs
models/Mitsubishi/Rysunki 3D/RV-12/_RV_12SL__RV_12SDL 1/rv-12s_base_assy_asm.igs
models/Modele 3D/Mitsubishi/RV-12/_RV_12SL__RV_12SDL 1/rv-12sl_no1arm_assy_asm.igs
models/Mitsubishi/Rysunki 3D/RV-12/_RV_12SL__RV_12SDL 1/rv-12sl_no1arm_assy_asm.igs
models/Modele 3D/Mitsubishi/RV-12/_RV_12SL__RV_12SDL 1/rv-12s_no2arm_assy_asm.igs
models/Modele 3D/Mitsubishi/RV-12/_RV_12SL__RV_12SDL 1/rv-12s_base_assy_asm.igs
models/Modele 3D/Mitsubishi/RV-12/_RV_12SL__RV_12SDL 1/rv-12sl_asm.igs
models/Mitsubishi/Rysunki 3D/RV-12/_RV_12SL/Bu160c754B_RV-12SL_OUTLOOK.dwg
models/Modele 3D/Mitsubishi/RV-12/_RV_12SL/Bu160c754B_RV-12SL_OUTLOOK.dwg
models/Modele 3D/Mitsubishi/RV-12/RV_12SL_Robot_arm_reach__no_dimensions_.dxf
models/Mitsubishi/Rysunki 3D/RV-12/_RV_12SL/Bu160b755B_RV-12SL_MOVINGAREA.dwg
models/Modele 3D/Mitsubishi/RV-12/_RV_12SL/Bu160b755B_RV-12SL_MOVINGAREA.dwg
src/kawasaki/22.stl
models/Mitsubishi/Rysunki 3D/RV-12/_RV_12SL__RV_12SDL 1/rv-12sl_skelton.igs
models/Mitsubishi/Rysunki 3D/RV-12/RV_12SL_Robot_arm_reach__no_dimensions_.dxf
models/Modele 3D/Modele STL/mitsubishi/rv-12s_no2arm.stl
models/Modele 3D/Mitsubishi/RV-12/_RV_12SL__RV_12SDL 1/rv-12sl_skelton.igs
src/model/1-44b.stl
models/Modele 3D/Mitsubishi/RV-12/_RV_12SL__RV_12SDL 1/człon_1.stl
src/model/1-1.stl
src/kawasaki/1-0.stl
src/model/2-3.stl
models/Mitsubishi/Rysunki 3D/RV-12/_RV_12SL__RV_12SDL 1/człon_1.stl
src/model/1-44a.stl
models/Modele 3D/Mitsubishi/RV-12/_RV_12SL__RV_12SDL 1/rv-12s_no2arm_cover_a.igs
src/kawasaki/4b.stl
models/Modele 3D/Modele STL/mitsubishi/rv-12s_j6_flange.stl
models/Modele 3D/Mitsubishi/RV-12/_RV_12SL__RV_12SDL 1/rv-12s_shoulder.igs
src/model/2-1.stl
models/Modele 3D/Modele STL/mitsubishi/rv-12s_elbo_cover_a.stl
src/kawasaki/21.stl
src/model/2-2.stl
models/Modele 3D/Mitsubishi/RV-12/_RV_12SL__RV_12SDL 1/rv-12s_j6_crbrg_spacer.igs
models/Modele 3D/Modele STL/mitsubishi/czlon_0_podstawaN.stl
models/Mitsubishi/Rysunki 3D/RV-12/_RV_12SL__RV_12SDL 1/rv-12s_shoulder.igs
models/Modele 3D/Modele STL/mitsubishi/rv-12s_elbo.stl
src/kawasaki/5.stl
src/model/2-22.stl
models/Modele 3D/Modele STL/mitsubishi/czlon_1_meshlab.stl
src/model/1-55.stl
models/Modele 3D/Modele STL/mitsubishi/rv-12s_shoulder_cover.stl
src/model/1-66.stl
models/Mitsubishi/Rysunki 3D/RV-12/_RV_12SL__RV_12SDL 1/człon_0_podstawaN.stl
models/Modele 3D/Mitsubishi/RV-12/_RV_12SL__RV_12SDL 1/człon_0_podstawaN.stl
models/Modele 3D/Modele STL/mitsubishi/czlon_1.stl
src/kawasaki/222.stl
models/Modele 3D/Mitsubishi/RV-12/_RV_12SL__RV_12SDL 1/rv-12sl_j4_ex_flange.igs
src/model/2-33.stl
models/Mitsubishi/Rysunki 3D/RV-12/_RV_12SL__RV_12SDL 1/rv-12sl_j4_ex_flange.igs
models/Modele 3D/Mitsubishi/RV-12/_RV_12SL__RV_12SDL 1/rv-12s_no2arm_cover_b.igs
src/model/1-33.stl
models/Mitsubishi/Rysunki 3D/RV-12/_RV_12SL__RV_12SDL 1/rv-12s_no2arm_cover_a.igs
models/Mitsubishi/Rysunki 3D/RV-12/_RV_12SL__RV_12SDL 1/rv-12s_j6_crbrg_spacer.igs
models/Mitsubishi/Rysunki 3D/RV-12/_RV_12SL__RV_12SDL 1/rv-12s_base.igs
models/Modele 3D/Mitsubishi/RV-12/_RV_12SL__RV_12SDL 1/rv-12s_base.igs
src/model/robo.obj
models/Mitsubishi/Rysunki 3D/RV-12/_RV_12SL__RV_12SDL 1/rv-12s_no2arm_cover_b.igs
src/model/1-4b.stl
src/model/1-0.stl
src/model/1-6.stl
src/model/1-2.stl
src/model/1.stl
models/Kawasaki/Rysunki 3D/Robot FS006L/fs006l-ip.dwg
models/Kawasaki/Rysunki 3D/Robot FS006L/fs006l.igs
models/Kawasaki/Rysunki 3D/Robot FS006L/fs006l.stl
models/Mitsubishi/Rysunki 3D/RV-12/_RV_12SL__RV_12SDL 1/rv-12s_elbo.stl
models/Mitsubishi/Rysunki 3D/RV-12/_RV_12SL__RV_12SDL 1/rv-12s_elbo_cover_a.stl
models/Mitsubishi/Rysunki 3D/RV-12/_RV_12SL__RV_12SDL 1/rv-12s_j6_flange.stl
models/Mitsubishi/Rysunki 3D/RV-12/_RV_12SL__RV_12SDL 1/rv-12s_no2arm.stl
models/Mitsubishi/Rysunki 3D/RV-12/_RV_12SL__RV_12SDL 1/rv-12s_shoulder_cover.stl
models/Modele 3D/Kawasaki/fs006l-ip.dwg
models/Modele 3D/Kawasaki/fs006l.igs
models/Modele 3D/Kawasaki/fs006l.stl
models/Modele 3D/Mitsubishi/RV-12/_RV_12SL__RV_12SDL 1/rv-12s_elbo.stl
models/Modele 3D/Mitsubishi/RV-12/_RV_12SL__RV_12SDL 1/rv-12s_elbo_cover_a.stl
models/Modele 3D/Mitsubishi/RV-12/_RV_12SL__RV_12SDL 1/rv-12s_j6_flange.stl
models/Modele 3D/Mitsubishi/RV-12/_RV_12SL__RV_12SDL 1/rv-12s_no2arm.stl
models/Modele 3D/Mitsubishi/RV-12/_RV_12SL__RV_12SDL 1/rv-12s_shoulder_cover.stl
models/Modele 3D/Modele STL/kawasaki/czlon_2.ply
models/Modele 3D/Modele STL/kawasaki/czlon_3.ply
models/Modele 3D/Modele STL/kawasaki/czlon_4.ply
models/Modele 3D/Modele STL/kawasaki/czlon_5.ply
models/Modele 3D/Modele STL/kawasaki/czlon_6_flansza.ply
models/Modele 3D/Modele STL/kawasaki/podstawa.ply
models/Modele 3D/Modele STL/mitsubishi/czlon_0_podstawaN.ply
models/Modele 3D/Modele STL/mitsubishi/czlon_1.obj
models/Modele 3D/Modele STL/mitsubishi/czlon_1.ply
models/Modele 3D/Modele STL/mitsubishi/rv-12s_shoulder.ply
models/Modele 3D/Modele STL/mitsubishi/rv-12s_shoulder_cover.ply
models/Modele 3D/Modele STL/tasma/00003.stl
models/Modele 3D/Modele STL/tasma/00004.stl
models/Modele 3D/Modele STL/tasma/00005.stl
models/Modele 3D/Modele STL/tasma/00006.stl
models/Modele 3D/Modele STL/tasma/00007.stl
models/Modele 3D/Modele STL/tasma/00008.stl
models/Modele 3D/Modele STL/tasma/00009.stl
models/Modele 3D/Modele STL/tasma/00010.stl
models/Modele 3D/Modele STL/tasma/00046.stl
models/Modele 3D/Modele STL/tasma/00047.stl
models/Modele 3D/Modele STL/tasma/00048.stl
models/Modele 3D/Modele STL/tasma/00296.stl
models/Modele 3D/Modele STL/tasma/00297.stl
models/Modele 3D/Modele STL/tasma/00298.stl
models/Modele 3D/Modele STL/tasma/00299.stl
models/Modele 3D/Modele STL/tasma/00300.stl
models/Modele 3D/Modele STL/tasma/00301.stl
models/Modele 3D/Modele STL/tasma/00302.stl
models/Modele 3D/Modele STL/tasma/00303.stl
models/Modele 3D/Modele STL/tasma/00304.stl
models/Modele 3D/Modele STL/tasma/00305.stl
models/Modele 3D/Modele STL/tasma/00306.stl
models/Modele 3D/Modele STL/tasma/00307.stl
models/Modele 3D/Modele STL/tasma/00308.stl
models/Modele 3D/Modele STL/tasma/00309.stl
models/Modele 3D/Modele STL/tasma/00310.stl
models/Modele 3D/Modele STL/tasma/00311.stl
models/Modele 3D/Modele STL/tasma/00312.stl
models/Modele 3D/Modele STL/tasma/00313.stl
models/Modele 3D/Modele STL/tasma/00314.stl
models/Modele 3D/Modele STL/tasma/00315.stl
models/Modele 3D/Modele STL/tasma/00316.stl
models/Modele 3D/Modele STL/tasma/00317.stl
models/Modele 3D/Modele STL/tasma/00318.stl
models/Modele 3D/Modele STL/tasma/00319.stl
models/Modele 3D/Modele STL/tasma/00320.stl
models/Modele 3D/Modele STL/tasma/00321.stl
models/Modele 3D/Modele STL/tasma/00322.stl
models/Modele 3D/Modele STL/tasma/00323.stl
models/Modele 3D/Modele STL/tasma/00324.stl
models/Modele 3D/Modele STL/tasma/00325.stl
models/Modele 3D/Modele STL/tasma/00326.stl
models/Modele 3D/Modele STL/tasma/00327.stl
models/Modele 3D/Modele STL/tasma/00328.stl
models/Modele 3D/Modele STL/tasma/00329.stl
models/Modele 3D/Modele STL/tasma/00330.stl
models/Modele 3D/Modele STL/tasma/00331.stl
models/Modele 3D/Modele STL/tasma/00332.stl
models/Modele 3D/Modele STL/tasma/00333.stl
models/Modele 3D/Modele STL/tasma/00334.stl
models/Modele 3D/Modele STL/tasma/00335.stl
models/Modele 3D/Modele STL/tasma/00336.stl
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
