annaivanytska/virtualLaboratory/bin/imgui.ini

[Window][Debug##Default]
Pos=60,60
Size=400,400
Collapsed=0

[Window][Dear ImGui Demo]
ViewportPos=1169,311
ViewportId=0xA4D966FE
Size=530,421
Collapsed=0
DockId=0x00000002,0

[Window][DockSpace Demo]
Size=800,600
Collapsed=0

[Window][Example: Custom rendering]
Pos=60,60
Size=623,414
Collapsed=0

[Window][Example: Console]
Pos=60,60
Size=520,600
Collapsed=0

[Window][Example: Assets Browser]
Pos=60,60
Size=800,480
Collapsed=0

[Window][Example: Documents]
Pos=60,60
Size=607,944
Collapsed=0

[Window][Example: Log]
Pos=60,60
Size=500,400
Collapsed=0

[Window][Example: Property editor]
Pos=60,60
Size=430,450
Collapsed=0

[Window][Example: Property editor/##tree_73339443]
IsChild=1
Size=300,415

[Window][Example: Simple layout]
Pos=60,60
Size=500,440
Collapsed=0

[Window][Example: Simple layout/left pane_AED60EF8]
IsChild=1
Size=150,386

[Window][Scene]
Pos=333,389
Size=64,38
Collapsed=0

[Window][GameWindow]
ViewportPos=1097,213
ViewportId=0x7B1E6A28
Size=742,506
Collapsed=0

[Window][Options]
ViewportPos=1209,228
ViewportId=0x1F88C31B
Size=253,141
Collapsed=0

[Window][Robot Arm Controls]
ViewportPos=1104,395
ViewportId=0x66B59992
Size=533,445
Collapsed=0

[Window][Move Robot Arm]
Pos=60,60
Size=142,123
Collapsed=0

[Window][Inverse Kinematics]
ViewportPos=1169,311
ViewportId=0xA4D966FE
Pos=0,423
Size=530,218
Collapsed=0
DockId=0x00000003,0

[Window][Robot Commands]
Pos=60,60
Size=281,149
Collapsed=0

[Window][Menu]
Pos=54,296
Size=381,410
Collapsed=0
DockId=0x00000002,0

[Table][0xDDC24BCA,2]
RefScale=13
Column 0  Sort=0v

[Table][0xAC9A836A,2]
RefScale=13
Column 0  Width=4
Column 1  Weight=2.0000

[Docking][Data]
DockNode    ID=0x00000001 Pos=255,531 Size=381,410 Split=Y Selected=0xA57AB2C6
  DockNode  ID=0x00000002 Parent=0x00000001 SizeRef=530,421 Selected=0xA57AB2C6
  DockNode  ID=0x00000003 Parent=0x00000001 SizeRef=530,218 Selected=0xF4E04B34
