annaivanytska/virtualLaboratory/include/dh.h

// #include <glm/glm.hpp>

// class DHParameters {
//     public:
//     float theta;  // Kąt obrotu wokół osi Z
//     float d;      // Przesunięcie wzdłuż osi Z
//     float a;      // Przesunięcie wzdłuż osi X
//     float alpha;  // Kąt obrotu wokół osi X

//         DHParameters(float theta, float d, float a, float alpha);

//         glm::mat4 ComputeDHMatrix(const DHParameters& params);
// };
