annaivanytska/virtualLaboratory/include/framebuffer.h

#ifndef FRAME_CLASS_H
#define FRAME_CLASS_H

#include <iostream>
#include <glad/glad.h>
#include <glm/glm.hpp>

class FrameBuffer
{
public:
	FrameBuffer(float width, float height);
	~FrameBuffer();
	unsigned int getFrameTexture();
	void RescaleFrameBuffer(float width, float height);
	void Bind() const;
	void Unbind() const;
private:
	unsigned int fbo;
	unsigned int texture;
	unsigned int rbo;
};

#endif
