annaivanytska/virtualLaboratory/src/imgui_renderer.cpp

#include "imgui_renderer.h"

ImguiRenderer::ImguiRenderer(GLFWwindow *window)
{
    IMGUI_CHECKVERSION();
    ImGui::CreateContext();
    ImGuiIO& io = ImGui::GetIO(); (void)io;
    io.ConfigFlags |= ImGuiConfigFlags_NavEnableKeyboard; 
    io.ConfigFlags |= ImGuiConfigFlags_DockingEnable;
    io.ConfigFlags |= ImGuiConfigFlags_ViewportsEnable; 

    ImGui_ImplGlfw_InitForOpenGL(window, true);
	ImGui_ImplOpenGL3_Init();

}

void ImguiRenderer::NewFrame()
{
    ImGui_ImplOpenGL3_NewFrame();
    ImGui_ImplGlfw_NewFrame();    
    ImGui::NewFrame();
}

void ImguiRenderer::DemoWindow()
{
    ImGui::ShowDemoWindow();
}

void ImguiRenderer::Render()
{
    ImGuiIO& io = ImGui::GetIO(); (void)io;
    ImGui::Render();
    ImGui_ImplOpenGL3_RenderDrawData(ImGui::GetDrawData());
    if (io.ConfigFlags & ImGuiConfigFlags_ViewportsEnable)
    {
        GLFWwindow* backup_current_context = glfwGetCurrentContext();
        ImGui::UpdatePlatformWindows();
        ImGui::RenderPlatformWindowsDefault();
        glfwMakeContextCurrent(backup_current_context);
    }
}

void ImguiRenderer::Delete()
{
    ImGui_ImplOpenGL3_Shutdown();
    ImGui_ImplGlfw_Shutdown();
    ImGui::DestroyContext(); 
}
