annaivanytska/virtualLaboratory/(commit log)

2024-10-11 add new files
    [00003.stl, 00004.stl, 00005.stl, 00006.stl, 00007.stl, 00008.stl, 00009.stl, 00010.stl]
2025-04-29 add main project
    [00.stl, 000.obj, 01.stl, 1-0.stl, 1-1.stl, 1-11.stl, 1-2.stl, 1-22.stl]
